skot/bitcart-node/bitcart.kicad_pcb

## KiCad design bitcart.kicad_pcb (2022-06-17)

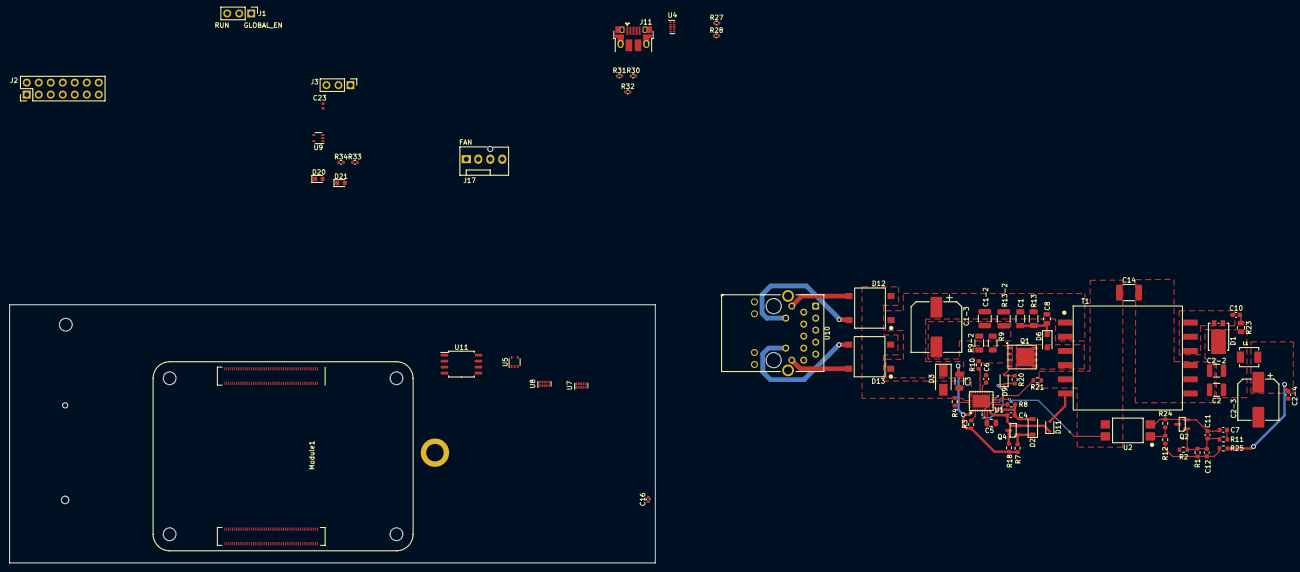
[picture p1: board bitcart.kicad_pcb from above]

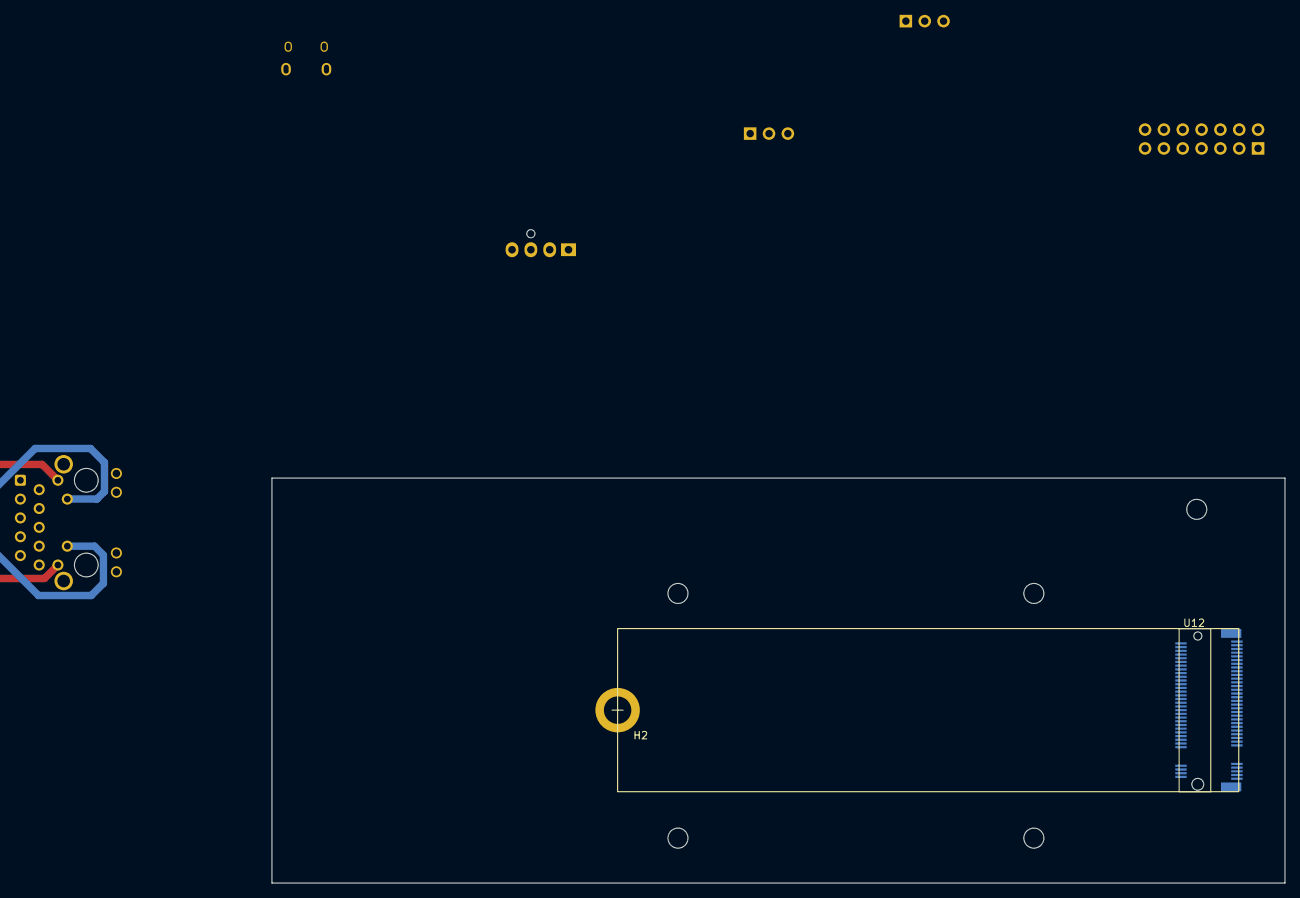
[picture p2: board bitcart.kicad_pcb from below]

Board: 4 copper layers, 136.6 x 54.6 mm, 78 parts (2 on the bottom side), 81 nets.

Parts:
C1, C1-2: 2.2uF; C_1210_3225Metric
C1-3: 47uF; CP_Elec_10x10.5
C2, C2-2: 22uF; C_1210_3225Metric
C2-3: 220uF; CP_Elec_8x10.5
C2-4, C7: 0.1uF; C_0603_1608Metric
C3: 0.1uF, 100V; R_1206_3216Metric
C4: 1uF; C_0603_1608Metric
C5: 4.7uF; C_0805_2012Metric
C6: 0.22uF; C_0603_1608Metric
C8: 0.1uF; C_0805_2012Metric
C10: 0.47nF; C_0603_1608Metric
C11: 220pF; C_0603_1608Metric
C12: 680pF; C_0603_1608Metric
C14: 1nF, 2000V; C_1812_4532Metric
C16, C23: 100n; C_0402_1005Metric
D1: SBR8U60P5-13
D2: 9.1V; D_SOD-123
D3: SMAJ58A; D_SMA
D6: BAV21; D_SOD-123F
D9, D11: 1N4148WS; D_SOD-323
D12, D13: DF01S
D20: LED Red; LED_0603_1608Metric
D21: LED Green; LED_0603_1608Metric
H1: MountingHole; MountingHole_2.7mm_M2.5
H2: M2.5 x 2.5mm SMD threaded standoff; 9774025151R
J1, J3: Conn_01x03; PinHeader_1x03_P2.54mm_Vertical
J2: Conn_02x07_Odd_Even; PinHeader_2x07_P2.54mm_Vertical
J11: USB_OTG; USB_Micro-B_EDAC_UCON00686
J17: Molex 470531000; FanPinHeader_1x04_P2.54mm_Vertical
L1: 0.1uH; IND_744373240010
Module1: ComputeModule4; Raspberry-Pi-4-Compute-Module
Q1: SI7430DP
Q2: TL432DBZ; SOT-23
Q4: MMBTA06LT1G; SOT-23
R1, R2: 191k; R_0603_1608Metric
R3: 24.9k; R_0603_1608Metric
R4: 28.7; R_0603_1608Metric
R7: 100k; R_0603_1608Metric
R8: 9.31k; R_0603_1608Metric
R9, R9-2: 0.082; R_1206_3216Metric
R10, R20: 4.99; R_0603_1608Metric
R11: 49.9k; R_0603_1608Metric
R12: 6.8k; R_0603_1608Metric
R13, R13-2: 20k; R_1206_3216Metric
R18: 1k; R_0603_1608Metric
R21: 10k; R_0603_1608Metric
R23: 20; R_0805_2012Metric
R24: 2k; R_0603_1608Metric
R25: 10; R_0603_1608Metric
R27, R28: 470R; R_0402_1005Metric
R30, R31: 2.2K 1%; R_0402_1005Metric
R32: 36K 1%; R_0402_1005Metric
R33, R34: 1k; R_0402_1005Metric
T1: 7491194912
U1: MP8008; QFN-28_EP_4x5_Pitch0.5mm
U2: FOD817S; SMDIP-4_W9.53mm
U4, U7, U8: TPD4EUSB30; USON-10_2.5x1.0mm_P0.5mm
U5, U9: 74LVC1G07SE-7; SOT-353_SC-70-5
U10: MagJack-A70-112-331N126; TRJG0926HENL
U11: EMC2301-1-ACZL-TR; SOIC-8_5.23x5.23mm_P1.27mm
U12: MDT320M01001

Connections:
/+3.3v: C23.1, D20.2 (A), D21.2 (A), Module1.78 (GPIO_VREF(1.8v/3.3v_Input)), Module1.84 (+3.3v_(Output)), Module1.86 (+3.3v_(Output)), R32.2, U5.5 (VCC), U11.3 (VDD)
/+5v: C2-3.1, C2-4.1, L1.2, Module1.77 (+5v_(Input)), Module1.79 (+5v_(Input)), Module1.81 (+5v_(Input)), Module1.83 (+5v_(Input)), Module1.85 (+5v_(Input)), Module1.87 (+5v_(Input)), R25.2, U9.5 (VCC)
/CM4_GPIO /+1.8v: Module1.88 (+1.8v_(Output)), Module1.90 (+1.8v_(Output))
/CM4_GPIO /AIN0: J2.5, Module1.96 (AnalogIP0)
/CM4_GPIO /AIN1: J2.6, Module1.94 (AnalogIP1)
/CM4_GPIO /BT_nDis: J3.3, Module1.91 (BT_nDisable)
/CM4_GPIO /EEPROM_nWP: J2.4, Module1.20 (EEPROM_nWP)
/CM4_GPIO /GLOBAL_EN: J1.1, J2.14, Module1.99 (Global_EN)
/CM4_GPIO /RUN_PG: J1.3, Module1.92 (RUN_PG), U9.2
/CM4_GPIO /SYNC_IN: J2.8, Module1.16 (Ethernet_SYNC_IN(1.8v))
/CM4_GPIO /SYNC_OUT: J2.9, Module1.18 (Ethernet_SYNC_OUT(1.8v))
/CM4_GPIO /TRD0_N: Module1.10 (Ethernet_Pair0_N), U8.4 (D2+), U8.7, U10.2 (TRD0-)
/CM4_GPIO /TRD0_P: Module1.12 (Ethernet_Pair0_P), U8.5 (D2-), U8.6, U10.1 (TRD0+)
/CM4_GPIO /TRD1_N: Module1.6 (Ethernet_Pair1_N), U8.2 (D1-), U8.9, U10.6 (TRD1-)
/CM4_GPIO /TRD1_P: Module1.4 (Ethernet_Pair1_P), U8.1 (D1+), U8.10, U10.3 (TRD1+)
/CM4_GPIO /TRD2_N: Module1.9 (Ethernet_Pair2_N), U7.4 (D2+), U7.7, U10.8 (TRD2-)
/CM4_GPIO /TRD2_P: Module1.11 (Ethernet_Pair2_P), U7.5 (D2-), U7.6, U10.7 (TRD2+)
/CM4_GPIO /TRD3_N: Module1.5 (Ethernet_Pair3_N), U7.2 (D1-), U7.9, U10.10 (TRD3-)
/CM4_GPIO /TRD3_P: Module1.3 (Ethernet_Pair3_P), U7.1 (D1+), U7.10, U10.9 (TRD3+)
/CM4_GPIO /WL_nDis: J3.1, Module1.89 (WL_nDisable)
/CM4_GPIO /nPWR_LED: Module1.95 (nPI_LED_PWR), U5.2
/CM4_GPIO /nRPIBOOT: J2.2, Module1.93 (nRPIBOOT)
/CM4_HighSpeed/PCIE_CLK_N: Module1.112 (PCIe_CLK_N), U12.53 (REFCLKn)
/CM4_HighSpeed/PCIE_CLK_P: Module1.110 (PCIe_CLK_P), U12.55 (REFCLKp)
/CM4_HighSpeed/PCIE_RX_N: Module1.118 (PCIe_RX_N), U12.41 (PETn0)
/CM4_HighSpeed/PCIE_RX_P: Module1.116 (PCIe_RX_P), U12.43 (PETp0)
/CM4_HighSpeed/PCIE_TX_N: Module1.124 (PCIe_TX_N), U12.47 (PERn0)
/CM4_HighSpeed/PCIE_TX_P: Module1.122 (PCIe_TX_P), U12.49 (PERp0)
/CM4_HighSpeed/PCIE_nRST: Module1.109 (PCIe_nRST), U12.50 (PREST)
/CM4_HighSpeed/USBOTG_ID: Module1.101 (USB_OTG_ID), R30.1, R31.2
/PCIe-connector/+3.3V: U12.2 (3.3V), U12.4 (3.3V), U12.12 (3.3V), U12.14 (3.3V), U12.16 (3.3V), U12.18 (3.3V), U12.70 (3.3V), U12.72 (3.3V), U12.74 (3.3V)
/PoE/+3.3v: U10.15 (LEDG_A), U10.17 (LEDY_A)
/PoE/COMP: U1.11 (COMP), U2.4
/PoE/GND1: C1.2, C1-2.2, C1-3.2, C4.2, C5.2, C6.2, C14.1, D2.2 (A), R8.1, R9.1, R9-2.1, R21.1, T1.5, U1.9 (GND), U1.20 (RTN), U1.21 (RTN), U1.29 (EP), U2.3
/PoE/ISQ: Q1.1 (S), Q1.2 (S), Q1.3 (S), R9.2, R9-2.2, R10.1
/PoE/LS: C2.1, C2-2.1, D1.1 (K), L1.1, R23.1
/PoE/NS: C10.1, D1.2 (A), D1.3 (A), T1.10, T1.11, T1.12
/PoE/TR0_TAP: D12.3, U10.11 (VC1)
/PoE/TR1_TAP: D12.4, U10.12 (VC2)
/PoE/TR2_TAP: D13.3, U10.13 (VC3)
/PoE/TR3_TAP: D13.4, U10.14 (VC4)
/PoE/VDD: C1.1, C1-2.1, C1-3.1, C3.1, C8.1, D3.1 (K), D12.1 (+), D13.1 (+), R3.2, R7.2, R13.2, R13-2.2, R18.2, T1.1, T1.2, U1.1 (AUX), U1.3 (VDD)
/PoE/VIN: C4.1, D11.1 (K), Q4.2 (E), U1.8 (VIN)
/PoE/VSS: C3.2, D3.2 (A), D12.2 (-), D13.2 (-), R4.1, U1.23 (VSS), U1.24 (VSS), U1.25 (FTY)
/PoE/W1: D6.2 (A), Q1.5 (D), T1.3, T1.4
/PoE/W2: D11.2 (A), T1.6
/PoE/W3: R12.2, R24.2, U2.1
/PoE/W4: C7.1, C11.1, Q2.2 (K), R24.1, U2.2
/USB2-HUB/USBD_N: J11.2 (D-), U4.4 (D2+), U4.7
/USB2-HUB/USBD_P: J11.3 (D+), U4.5 (D2-), U4.6
GND: C2.2, C2-2.2, C2-3.2, C2-4.2, C14.2, C16.2, C23.2, J1.2, J2.1, J2.3, J2.7, J2.10, J2.12, J3.2, J11.5 (GND), J11.6 (Shield), J17.1, Module1.1 (GND), Module1.2 (GND), Module1.7 (GND), Module1.8 (GND), Module1.13 (GND), Module1.14 (GND), Module1.22 (GND), Module1.23 (GND), Module1.32 (GND), Module1.33 (GND), Module1.42 (GND), Module1.43 (GND), Module1.52 (GND), Module1.53 (GND), Module1.59 (GND), Module1.60 (GND), Module1.65 (GND), Module1.66 (GND), Module1.71 (GND), Module1.74 (GND), Module1.98 (GND), Module1.107 (GND), Module1.108 (GND), Module1.113 (GND), Module1.114 (GND), Module1.119 (GND), Module1.120 (GND), Module1.125 (GND), Module1.126 (GND), Module1.131 (GND), Module1.132 (GND), Module1.137 (GND), Module1.138 (GND), Module1.144 (GND), Module1.150 (GND), Module1.155 (GND), Module1.156 (GND), Module1.161 (GND), Module1.162 (GND), Module1.167 (GND), Module1.168 (GND), Module1.173 (GND), Module1.174 (GND), Module1.179 (GND), Module1.180 (GND), Module1.185 (GND), Module1.186 (GND), Module1.191 (GND), Module1.192 (GND), Module1.197 (GND), Module1.198 (GND), Q2.3 (A), R2.1, R30.2, T1.7, T1.8, T1.9, U4.3 (GND), U4.8 (GND), U5.3 (GND), U7.3 (GND), U7.8 (GND), U8.3 (GND), U8.8 (GND), U9.3 (GND), U10.19 (SHIELD), U10.20 (SHIELD), U11.4 (GND), U12.1 (GND), U12.3 (GND), U12.9 (GND), U12.15 (GND), U12.21 (GND), U12.27 (GND), U12.33 (GND), U12.39 (GND), U12.45 (GND), U12.51 (GND), U12.57 (GND), U12.69 (PEDET), U12.71 (GND), U12.73 (GND), U12.75 (GND), U12.76, U12.77
unnamed: C5.1, U1.7 (VCC)
unnamed: C6.1, U1.18 (SS)
unnamed: C8.2, D6.1 (K), R13.1, R13-2.1
unnamed: C10.2, R23.2
unnamed: C11.2, C12.2, Q2.1 (REF), R1.1, R2.2, R11.1
unnamed: C12.1, R1.2, R12.1, R25.1
unnamed: C16.1, U10.4 (CT), U10.5 (CT)
unnamed: D2.1 (K), Q4.1 (B), R7.1
unnamed: D9.1 (K), R20.2, U1.6 (GATE)
unnamed: D9.2 (A), Q1.4 (G), R20.1
unnamed: D21.1 (K), R34.1
unnamed: J2.13, U9.4
unnamed: J11.1 (VBUS), R31.1
unnamed: J17.3, R32.1, U11.6 (TACH)
unnamed: J17.4, U11.5 (PWM)
unnamed: Module1.21 (PI_nLED_Activity), R34.2
unnamed: Q4.3 (C), R18.1
unnamed: R3.1, U1.2 (DET)
unnamed: R4.2, U1.26 (CLASS)
unnamed: R8.2, U1.10 (RT)
unnamed: R10.2, U1.19 (ISENSE)
unnamed: C7.2, R11.2
unnamed: R21.2, U1.12 (FB)
unnamed: R27.1, U10.16 (LEDG_K)
unnamed: R28.1, U10.18 (LEDY_K)
unnamed: D20.1 (K), R33.1
unnamed: U1.5 (PG), U1.13 (EN/SYNC)
unnamed: U4.1 (D1+), U4.10
unnamed: U4.2 (D1-), U4.9
unnamed: R33.2, U5.4
