skot/bitcart-node/(commit log)

2022-06-02 initial import
    [CM4_GPIO.kicad_sch, CM4_HighSpeed.kicad_sch, PCIe.kicad_sch, PSUs.kicad_sch, RTC.kicad_sch, USB2-HUB.kicad_sch, bitcart.kicad_pcb, bitcart.kicad_sch]
2022-06-03 removed many unused parts
    [CM4_GPIO.kicad_sch, CM4_HighSpeed.kicad_sch, PCIe.kicad_sch, PSUs.kicad_sch, RTC.kicad_sch, USB2-HUB.kicad_sch, bitcart.kicad_pcb, bitcart.kicad_sch]
2022-06-03 added PoE schematic
    [CM4_GPIO.kicad_sch, bitcart.kicad_sch, poe.kicad_sch]
2022-06-03 added M.2 m-key connector to schematic
    [PCIe.kicad_sch, bitcart.kicad_sch, poe.kicad_sch]
2022-06-03 schematic cleanup
    [CM4_GPIO.kicad_sch, CM4_HighSpeed.kicad_sch, bitcart.kicad_sch]
2022-06-15 removed unused components
    [PCIe.kicad_sch, bitcart.kicad_pcb, bitcart.kicad_sch, poe.kicad_sch]
2022-06-16 added the M.2 connector and MP8008 footprints
    [CM4_GPIO.kicad_sch, PCIe.kicad_sch, bitcart.kicad_pcb, bitcart.kicad_sch, poe.kicad_sch]
2022-06-16 adding PoE parts
    [PCIe.kicad_sch, bitcart.kicad_pcb, bitcart.kicad_sch, poe.kicad_sch]
2022-06-16 added flyback mosfet footprint
    [bitcart.kicad_pcb, bitcart.kicad_sch, poe.kicad_sch]
2022-06-16 added a bunch more PoE footprints
    [bitcart.kicad_pcb, bitcart.kicad_sch, poe.kicad_sch]
2022-06-16 yet more PoE footprints
    [bitcart.kicad_sch, poe.kicad_sch]
2022-06-16 all footprints added?!
    [bitcart.kicad_pcb, bitcart.kicad_sch, poe.kicad_sch]
2022-06-16 changed PoE transformer to Wurth 7491194912
    [CM4_GPIO.kicad_sch, RTC.kicad_sch, USB2-HUB.kicad_sch, bitcart.kicad_pcb, bitcart.kicad_sch, poe.kicad_sch]
2022-06-17 started routing PoE
    [CM4_GPIO.kicad_sch, RTC.kicad_sch, USB2-HUB.kicad_sch, bitcart.kicad_pcb, bitcart.kicad_sch, poe.kicad_sch]
